AdamS-0/attiny13a_dice/imgs/img1.jpg

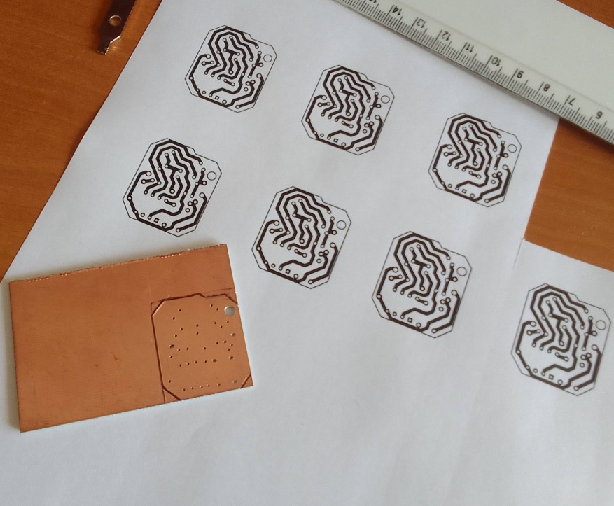
imgs/img1.jpg
