AdamS-0/attiny13a_dice/imgs/img2.jpg

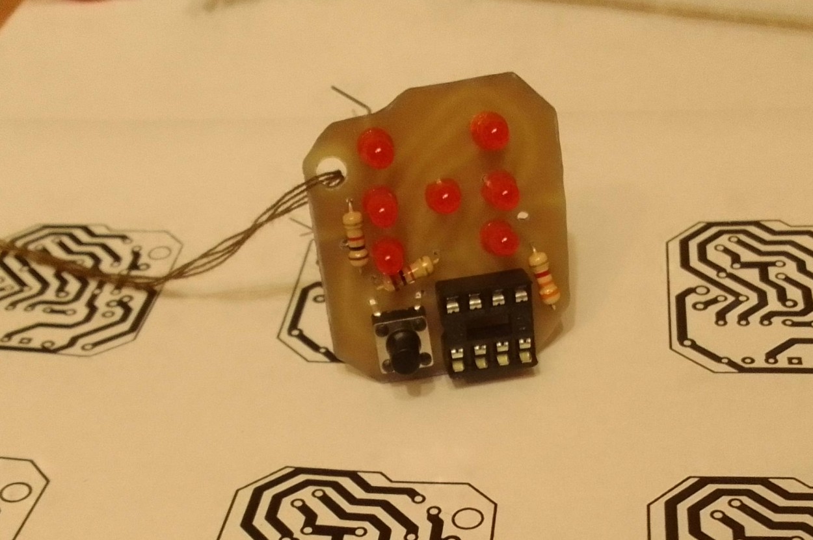
imgs/img2.jpg
