AdamS-0/attiny13a_dice/imgs/img3.jpg

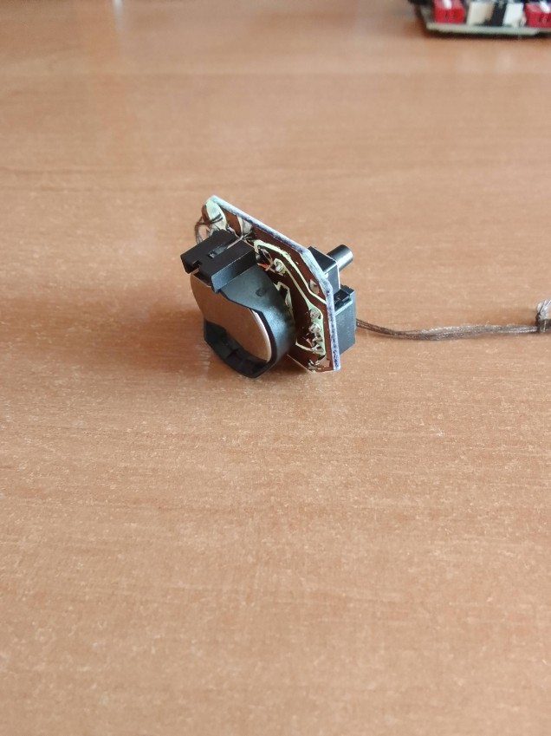
imgs/img3.jpg
